rhubarb0719/GaitGuard/docs/HWSW2-poster.pdf

# GaitGuard: TinyML-based fall risk assessment for older adults using

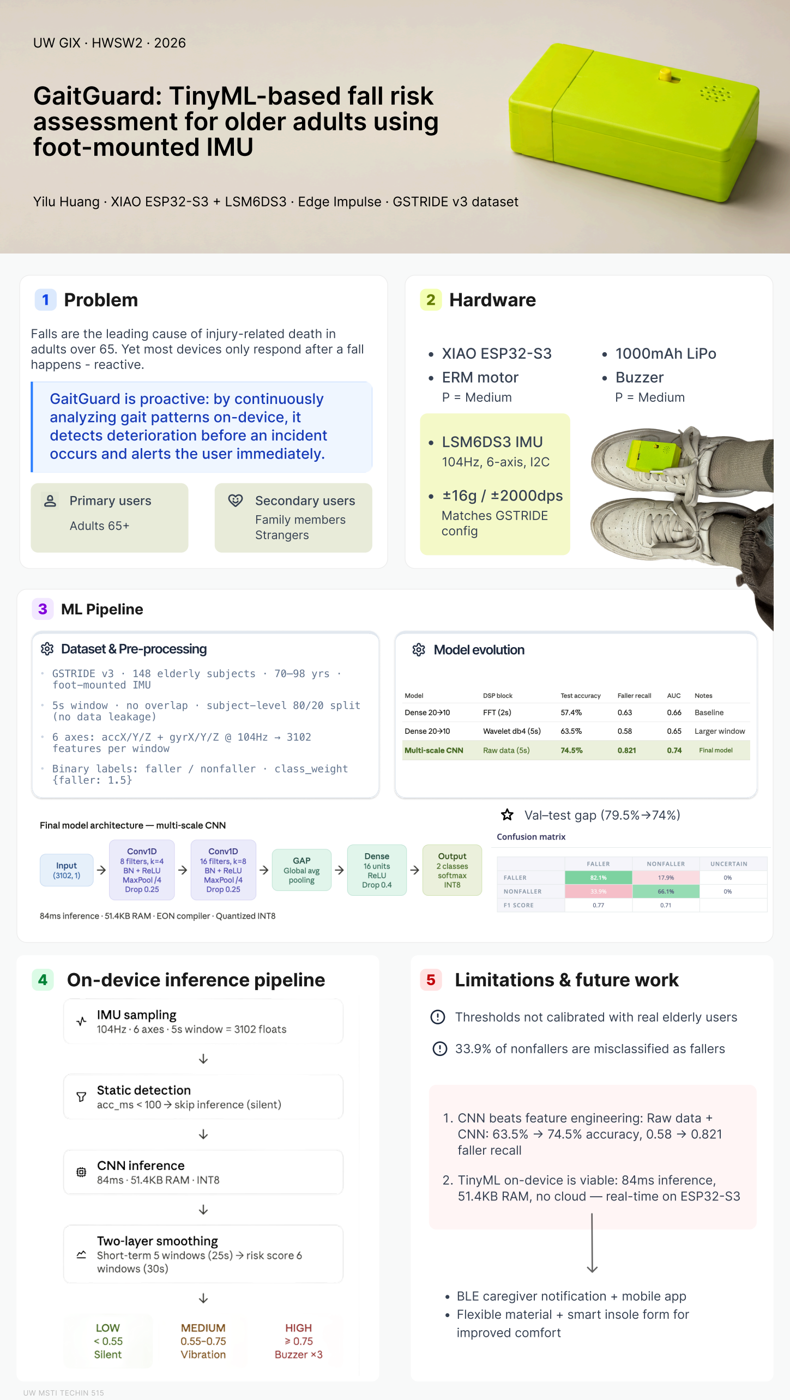
[picture p2: page 1]

UW GIX · HWSW2 · 2026

# foot-mounted IMU

Yilu Huang · XIAO ESP32-S3 + LSM6DS3 · Edge Impulse · GSTRIDE v3 dataset

1 | Problem | 2 Hardware

Falls are the leading cause of injury-related death in
adults over 65. Yet most devices only respond after a fall happens - reactive.
| GaitGuard is proactive: by continuously analyzing gait patterns on-device, it detects deterioration before an incident occurs and alerts the user immediately.

XIAO ESP32-S3

ERM motor

P = Medium

L SM6DS3 IMU

104Hz, 6-axis, I2C

1000 mAh LiPo

B uzzer

P = Medium

Primary users

Adults 65+

Secondary users

Family members
Strangers

±16 g / ±2000dps

Matches GSTRIDE
config

3 ML Pipeline

•

•

•

•

Dataset & Pre-processing

GSTRIDE v3 · 148 elderly subjects · 70–98 yrs · foot-mounted IMU

5s window · no overlap · subject-level 80/20 split (no data leakage)

6 axes: accX/Y/Z + gyrX/Y/Z @ 104Hz → 3102 features per window

Binary labels: faller / nonfaller · class_weight {faller: 1.5}

Model evolution

Val test gap (79.5%→74%)

4 | On-device inference pipeline | 5 | Limitations & future work

Thresholds not calibrated with real elderly users

33.9% of nonfallers are misclassified as fallers

CNN beats feature engineering: Raw data + CNN: 63.5% → 74.5% accuracy, 0.58 → 0.821 faller recall

TinyML on-device is viable : 84ms inference, 51.4KB RAM, no cloud real-time on ESP32-S3

B LE caregiver notification + mobile app

Flexible material + smart insole form for

improved comfort

UW MSTI TECHIN 515
