rhubarb0719/GaitGuard/hardware/back layer.png

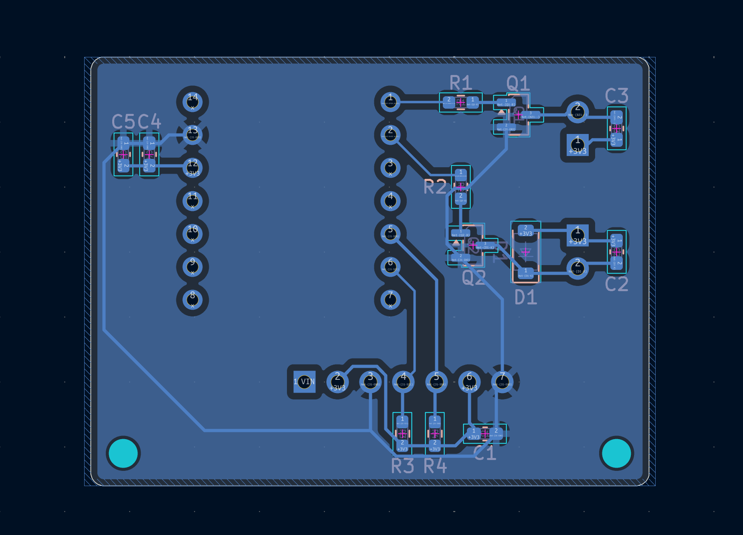
hardware/back layer.png
