rhubarb0719/GaitGuard/hardware/front layer.png

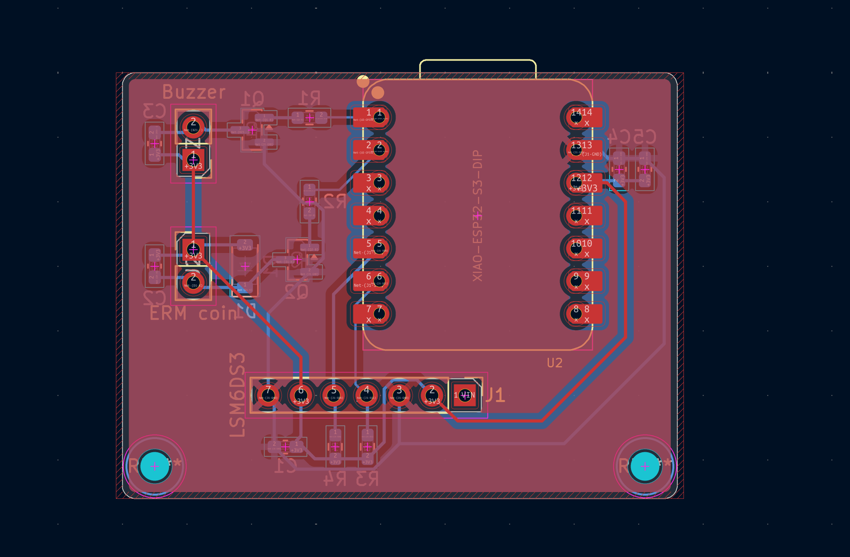
hardware/front layer.png
