rhubarb0719/GaitGuard/hardware/enclosure/盖子.stl

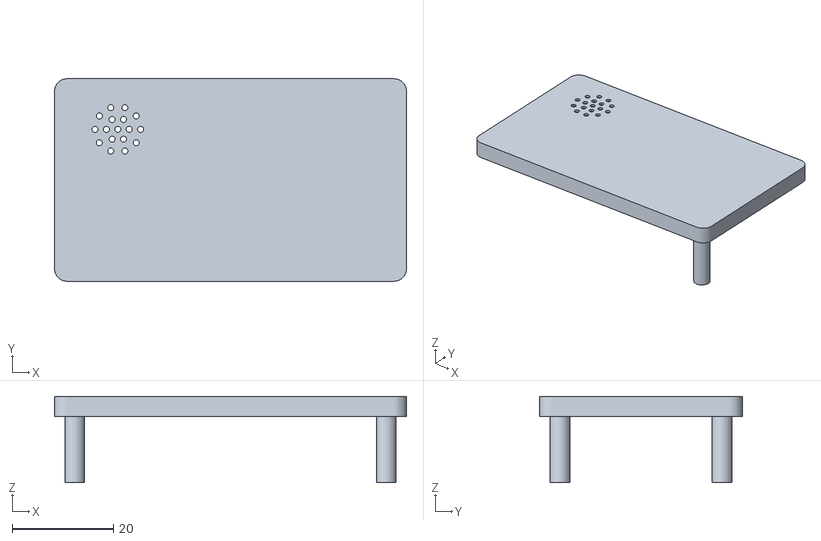
[picture p5: CAD file, 2026-06-02]
hardware/enclosure/盖子.stl
69.5 x 40.0 x 17.0
