rhubarb0719/GaitGuard/hardware/enclosure/扁嘴夹.3mf

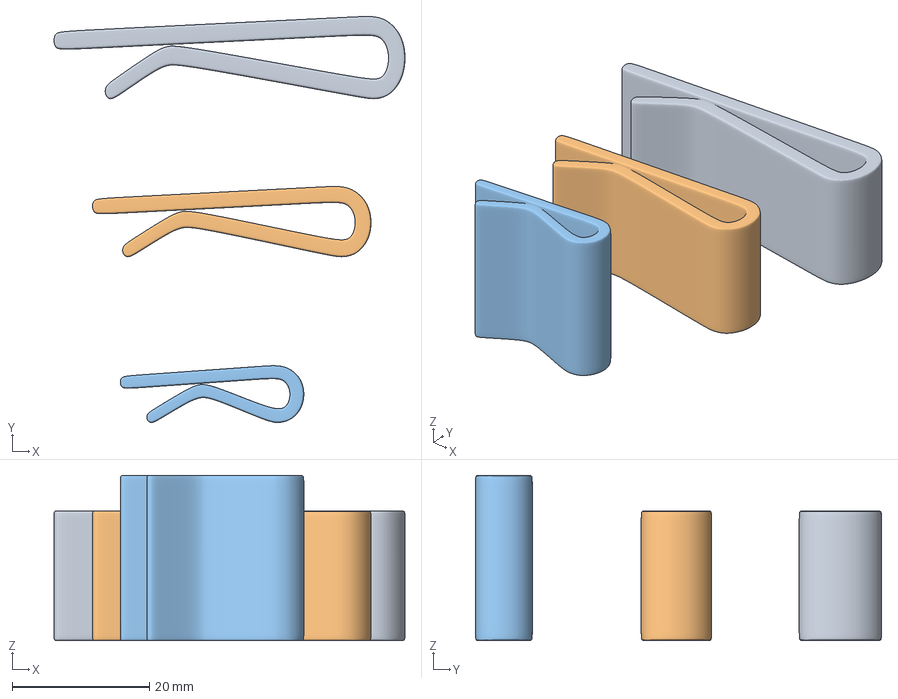
[picture p6: CAD file, 2026-06-02]
hardware/enclosure/扁嘴夹.3mf
51.2 x 59.2 x 24.1 mm
夹子2.stl_1
夹子2.stl_3
夹子2.stl_4
