rhubarb0719/GaitGuard/hardware/enclosure/底部.stl

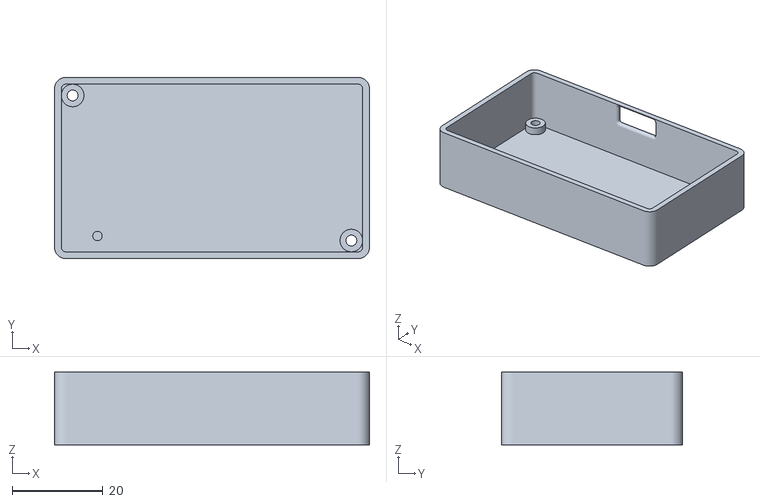
[picture p7: CAD file, 2026-06-02]
hardware/enclosure/底部.stl
69.5 x 40.0 x 16.0
