rhubarb0719/GaitGuard/hardware/Gaitgaurd.pdf

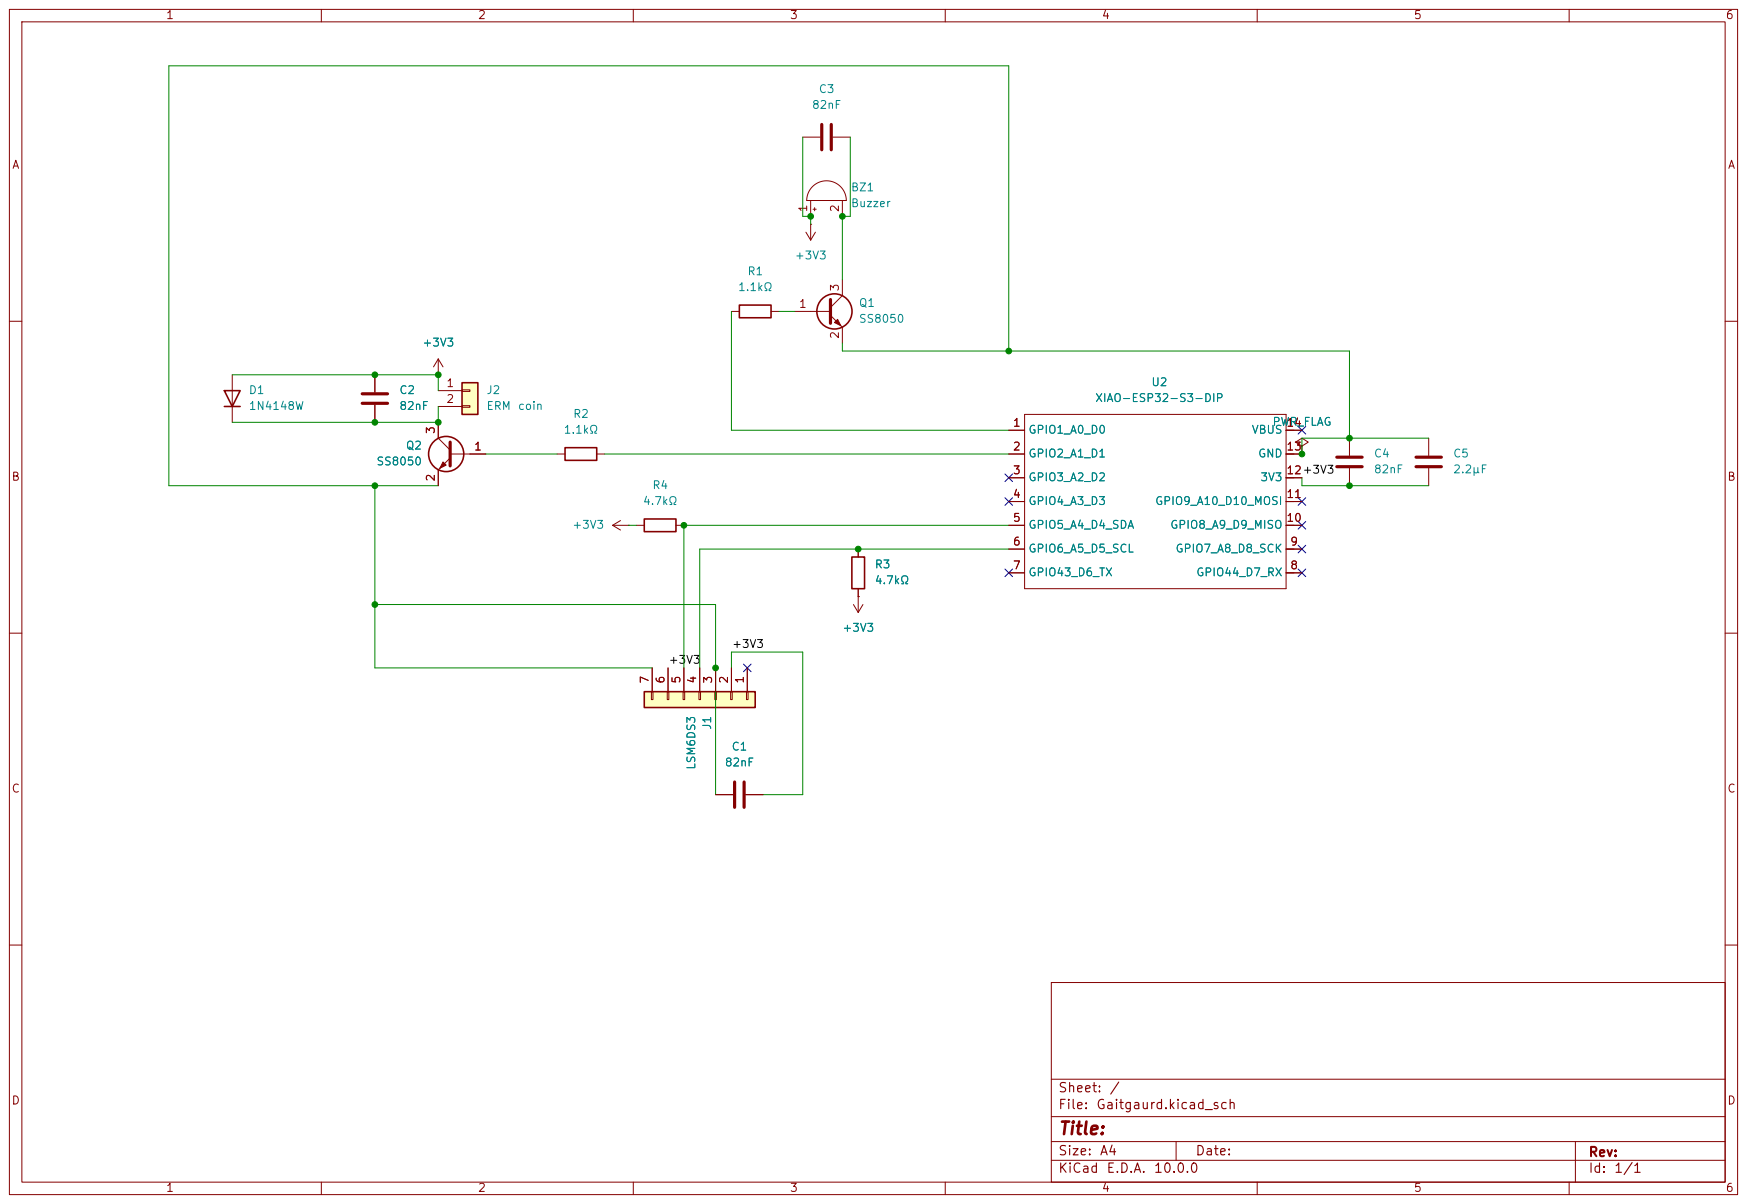
[picture p8: page 1]

Size: A4 | Rev:
KiCad E.D.A. 10.0.0 | Id: 1/1
