rhubarb0719/GaitGuard/hardware/printed enclosure.JPG

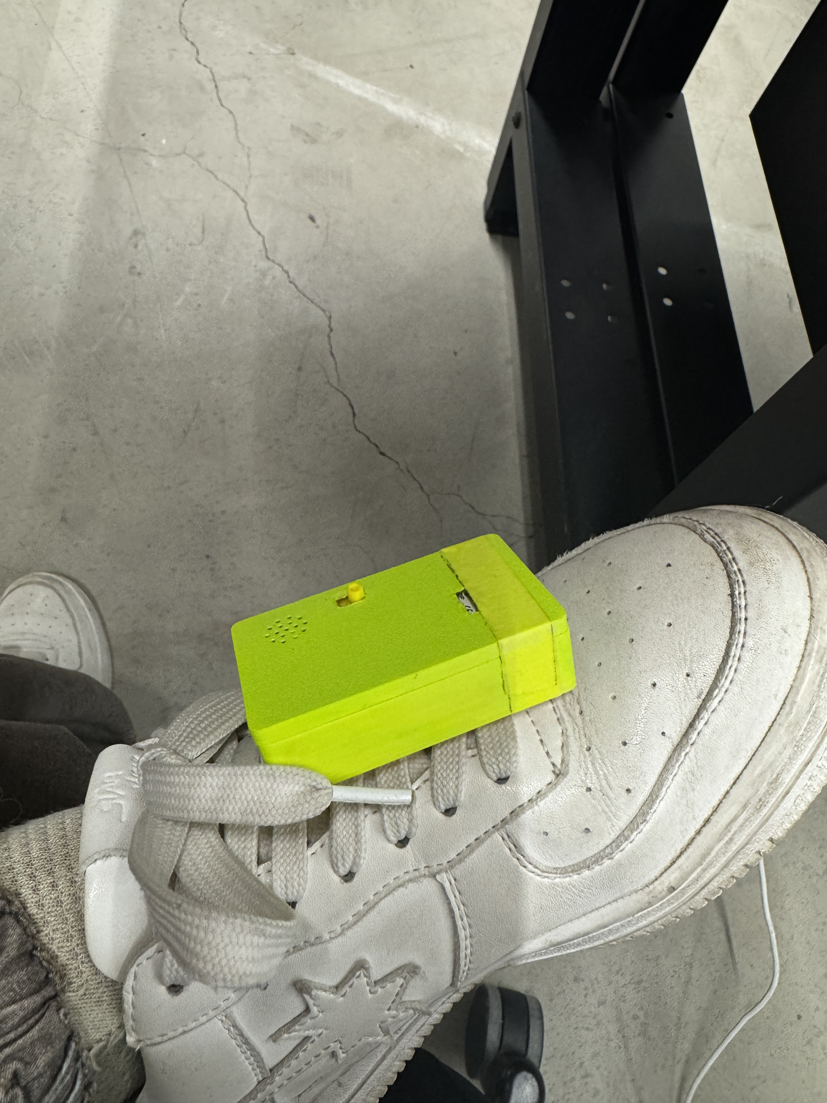
hardware/printed enclosure.JPG
